N2-Sumikko/sekimen/doc/trackball_jp.md

こちらはトラックボールモジュール取付用の資料です。
# 同梱品の確認
以下の部品が揃っていることを確認します。

|名前|合計数|備考|
|:-|:-|:-|
|トラックボールモジュール用ボトムプレート|1枚|大きな丸い穴が開いたアクリル製の透明な板です。トラックボールモジュールの台座です。|
|トッププレート|1枚|大きな四角い穴が開いたアクリル製の透明な板です。ProMicroカバーも兼ねています。|
|M2x4mmスペーサー|2個|銀色の六角柱の形をした部品です。長さ4㎜です。|
|M2x6mmスペーサー|2個|銀色の六角柱の形をした部品です。長さ6㎜です。|
|細ピンヘッダ1x4|1個|ピンが細めの4ピンのピンヘッダです。|
|トッププレート用保護テープ|1枚|黒色の幅2mmのテープです。シートに貼り付けてあります。複数ある場合は予備です。|

# 別途必要な部品の用意
以下の部品を用意します。

|名前|合計数|備考|
|:-|:-|:-|
|7mmオプティカルトラックボールモジュール１uタイプ|1個|ビット・トレード・ワン様のトラックボールモジュール(型番：ADTB7M)です。以下、トラックボールモジュールと呼びます。|
|トラックボールモジュール用レベル変換基板|1個|のぎけす屋様のトラックボールモジュール用レベル変換基板です。以下、変換基板と呼びます。|

いずれも遊舎工房様の実店舗、[通販サイト](https://yushakobo.jp/shop/)等で購入可能です。

# 組立時の主な注意点
* 左キーボードの組立時にロープロファイルピンソケット1x4をはんだ付けしていない場合、トラックボールモジュールの取付は出来ません。ご注意ください。

　(組立後のロープロファイルピンソケット1x4の取付けは、邪魔になるキースイッチを取り外した後にトッププレートの一部を削れば可能かと思いますが、きっと大変です。今度一回試してみます。）

* トラックボールモジュールの配線を変換基板にはんだ付けする際は、変換基板の向きにご注意ください。

* トラックボールモジュール用レベル変換基板にピンヘッダ1x4をはんだ付けする際は、変換基板の向きと端子の位置にご注意ください。(変換基板のNC端子は使用しません。)

* アクリル製の部品にスペーサーの取付けやねじ止めをする際は、強い力をかけると破損の恐れがあるのでご注意ください。

# (左キーボードを組立済の場合)ProMicroカバー、OLED、M2x12mmスペーサー2つ、キースイッチの取外し

左キーボードの組立て中にこのページを見ている場合、この項目は無視して構いません。

組立とは逆の手順で、ProMicroカバー、OLED、M2x12mmスペーサー2つ、トラックボールモジュールを取付ける場所のキースイッチ（ProMicroの左のキースイッチ）の順に取外していきます。

ただしキースイッチの取外しには、はんだの吸取が必要です。はんだの吸取にははんだ吸い取り機等、専用の道具が必要となります。

道具を用意するか、遊舎工房様の工作室等を利用する等、環境を整えてから作業してください。

# M2x4mmスペーサーの取付け

画像の様に、M2x10mmのねじ2本にM2x4mmスペーサーをそれぞれ取付けます。取付時のトルクは、スペーサーを回転させたときにねじが回らない位の強さならOKです。

取付時にProMicroが邪魔な場合は取り外しておきます。(画像では取外しています。）

M2x4mmスペーサー取付後

上側のスペーサーは、ねじの頭を爪楊枝等の細い棒で抑えながら取付けると良いです。

下側のスペーサーは、一度ボトムプレートを取り外した後に、基板側から精密ドライバーでねじの頭を抑えながら取付ると良いです。

# 変換基板へのトラックボールモジュール配線のはんだ付け

画像のように、変換基板へトラックボールモジュールの配線をはんだ付けします。変換基板の向きに注意して下さい。

トラックボールモジュールはんだ付け後

# 変換基板へのピンヘッダ1x4のはんだ付け

画像のように、変換基板へピンヘッダ1x4を取付け、はんだ付けします。短い端子が変換基板側です。変換基板のNC端子にはピンヘッダは取付けないので注意して下さい。

トラックボールモジュールはんだ付け後

# トラックボールモジュール用ボトムプレートの穴へ変換基板を通す

トラックボールモジュール用ボトムプレートの保護シートをはがします。

その後、画像の様に、トラックボールモジュール用ボトムプレートの穴へ変換基板を通します。

ボトムプレートを通した後

# ピンヘッダ1x4のロープロファイルピンソケット1x4へ取付け

画像の様に、変換基板へはんだ付けしたピンヘッダ1x4を、左キーボード上のロープロファイルピンソケット1x4に、トッププレートを介して取付けます。

併せて、トラックボールモジュール用ボトムプレートの穴にM2x10mmねじを通します。

変換基板とボトムプレートの取付け

# M2x10mmねじへのM2x6㎜スペーサーの取付け

画像の様に、Mx10mmねじ2本へM2x6mmスペーサーをそれぞれ取付けます。

M2x6mmスペーサー取付後

# OLED(及びProMicro）の取付け

(取り外している場合は、ProMicroをメイン基板に取り付けた後に）OLEDをメイン基板へ取付けます。

# トラックボールモジュールの配線位置の調整

画像を参考に、トラックボールモジュールの配線を、左キーボードのトッププレートやトラックボールモジュール用ボトムプレートの穴へ通し、トラックボールモジュールをボトムプレートの上に置けるようにします。

配線格納後

# トッププレートへの保護テープ貼付け

トッププレートの保護シールをはがした後、画像の様にトッププレートの丸穴に2mm幅の保護テープを貼付けます。

保護テープ貼付後

保護テープを貼る目的は、丸穴のエッジを触らないようにするためと、トラックボールモジュールの固定のためです。

保護テープを貼りたくない場合は、丸穴のエッジをカッターナイフの背などで糸面取りしてもOKです。糸面取りについては、「アクリル　糸面取り」等で検索すると情報が得られると思います。

その場合トラックボールモジュールの角度がずれやすくなるので、気になるようでしたらトラックボールモジュールの裏側に両面テープ等を貼り、ボトムプレートに固定すると良いです。

# トッププレートをM2x6mmスペーサーへM2x4mmねじでねじ止め

画像の様に、トッププレートの丸穴にトラックボールモジュールを保護テープがずれないよう気を付けながら取付けた後に、トッププレートをM2x6mmスペーサー2つへM2x4mmねじ2本でねじ止めします。

トッププレート取付後

取付が完了したら、トラックボールモジュールの取付は完了です。

# ファームウェアの変更

この手順は、動作テストのためのファームウェアの書込みが完了していることを前提としています。
(つまり、qmk_firmwareのcloneを自分のPC上にダウンロード完了している状態）
拡張基板を使用していない場合はqmkのsekimenフォルダの5colsフォルダ内、
拡張基板を使用している場合は７colsフォルダ内のrules.mkの
POINTING_DEVICE_ENABLE = no
MOUSEKEY_ENABLE = no
のnoをyesに変更します。
その後、ProMicroへファームウェアの書込みを行います。

ファームウェアの内容に関しては、[こちら](https://github.com/sekigon-gonnoc/qmk_firmware/tree/dev/ble_micro_pro/keyboards/helix/rev2/keymaps/bto_tb)のせきごん様のリンクをご参考ください。
