N2-Sumikko/sekimen/data/plate/dxf/extension_bottomplate.dxf

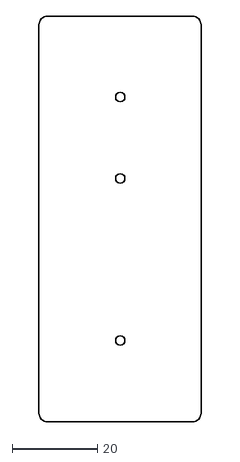
[picture p1: CAD file, 2020-11-23]
data/plate/dxf/extension_bottomplate.dxf
38.1 x 95.2
