N2-Sumikko/sekimen/data/plate/dxf/promicro_coverplate.dxf

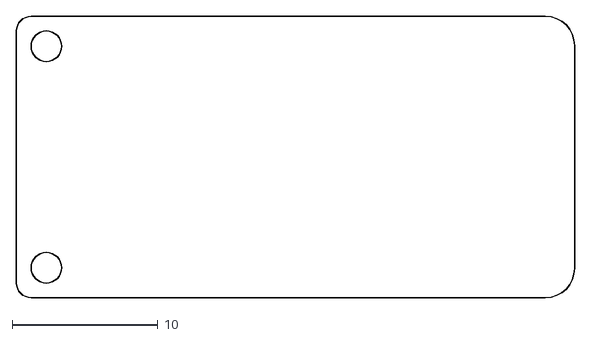
[picture p2: CAD file, 2020-11-23]
data/plate/dxf/promicro_coverplate.dxf
38.3 x 19.3
