N2-Sumikko/sekimen/data/plate/dxf/bottomplate.dxf

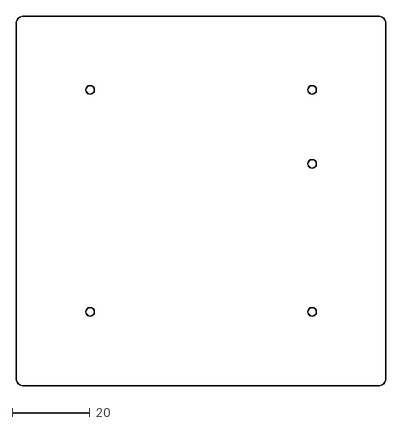
[picture p3: CAD file, 2020-11-23]
data/plate/dxf/bottomplate.dxf
95.2 x 95.2
