N2-Sumikko/sekimen/doc/Oparation_test_jp.md

# Operation test
こちらはsekimenの入力動作テスト用の資料です。

ファームウェア書込み環境を構築し、ProMicroへファームウェアを書き込み、キーボードの入力動作を確認するまでの手順を記載しています。(2020/07/30時点)

本手順はWindows(厳密にはWindows10)にてキャラクタユーザインターフェース用のソフトウェアであるMSYS2を使用する場合を基準にしています。

キーボード組立中や、キーボード組立後の入力動作テストにご活用ください。

# ファームウェア書込み環境の構築

ファームウェア書込み環境構築のため、QMK FirmwareのこちらのWeb ページ

https://docs.qmk.fm/#/ja/newbs_getting_started

を参考に、MSYS2及びgit、QMK CLIをインストールします。

また、こちらのWebページ等も非常に参考になるかと思います。(ページの作成者様にこの場を借りて感謝致します。)

https://qiita.com/mizuhof/items/0c34308c2d57c9345f3a

インストール後、PCのデスクトップ等に任意の名前のフォルダを1つ作成します。

(出来れば英語の、スペースを使用しないファイル名が良いです。github_workとか)

フォルダ

フォルダ作成後、フォルダの上にマウスカーソルを移動して右クリックします。その後「プロパティ」をクリックします。

クリック後、表示されたダイアログにて、画像の赤枠で囲んだ部分(フォルダのパス。フォルダの場所を示すもの）を控えておきます。

フォルダのパス

その後、MinGW 64-bit(mingw64.exe)を起動します。

mingw64起動後

起動後、次のコマンドを入力し、Enterキーを押します。

```
cd 控えておいたフォルダのパス(ただし、￥は/に置換えたもの)/作成したフォルダ
```

すると、先ほど作成したフォルダの中へ移動されます。画像の赤枠の部分が作成したフォルダのパスと一致していればOKです。

mingw64ファームウェア書込みフォルダ移動後

移動後、以下のコマンドを入力し、Enterキーを押します。(この部分はqmk_firmwareへのファームウェアのプルリクエストが完了するまでの仮の手順です。）

```
git clone --recurse-submodules https://github.com/N2-Sumikko/qmk_firmware.git -b add_sekimen
```

ファームウェア書込みに使用するフォルダが現在のフォルダにコピーされます。

その後、以下のコマンドを入力し、Enterキーを押します。

```
cd qmk_firmware
```

すると、ファームウェア書込みを行うフォルダの中へ移動されます。以上でファームウェア書込み環境の構築は完了です。

# ProMicroとPC間の接続

左右いずれかのProMicroの取付けまで完了したキーボードのProMicroとPC間をUSBケーブルで接続します。

sekimenは左キーボードのProMicroへUSBケーブルを接続して使用しますが、ファームウェアは左右両方のProMicroへ書き込む必要がありますので注意してください。

USBケーブルには充電のみ可能なものと、通信可能なものがありますので、通信可能なものを使用してください。

# ProMicroへのファームウェア書込み

接続後、ファームウェア書込み用のコマンドを入力し、Enterキーを押します。

通常時(5列)と拡張基板使用時(7列)でコマンドが違うので注意してください。

(defaultの部分は必要に応じてlike_jisやviaに変更してください。）

通常時
```
make sekimen/5cols:default:avrdude
```

拡張基板使用時
```
make sekimen/7cols:default:avrdude
```

すると、ファームウェアの書込みが開始されます。(書込み開始まで少し時間がかかる場合があるので、しばらく待ちます。)

しばらくすると画像のように「.」が 1つずつ増えていく状態になります。

mingw64リセット待機中

その状態で、画像のようにピンセット等でリセットスイッチを押します。(画像は説明のため、USBケーブルを取外しています。)

リセットスイッチ押下

リセットスイッチを押すと画面の状態が変わり、処理が先に進みます。画像のように「Thank you.」が表示されたら、ファームウェアの書込みは完了です。

ファームウェア書込み完了後

もう片方のキーボードに対しても同様の手順でファームウェアを書き込みます。

# 左右のキーボードのTRRSケーブルでの接続

左右のキーボードのTRRSジャック間をTRRSケーブルで接続します。TRRSケーブルは画像のように奥まで差し込んでください。

TRRSケーブル接続後

# **左キーボード**のProMicroとPC間をUSBケーブルで接続

**左キーボード**のProMicroとPC間をUSBケーブルで接続します。**左キーボード**ですので注意して下さい。

sekimenは左キーボードのProMicroにUSBケーブルを接続しないと正しく動作しません。

# 入力動作テスト

左右のキーボード間をTRRSケーブル、左キーボードとPC間をUSBケーブルで接続した状態で以下のURLをクリックし、キーボードテスター様のサイトを表示します。

https://www.keyboardtester.com/tester.html

その後、画像のようにピンセット等で、基板のキースイッチ用のランド(キースイッチの端子をはんだ付けする場所)間をショートさせます。

(ピンセットではなく、押した状態のキースイッチを使用して動作確認を兼ねるのも良いかと思います。スイッチがはんだ付け済みの場合はスイッチを押します。)

入力動作確認用

組立が正しく行われていれば、ショートさせた箇所に対応するキーが入力されます。

どのランドがどのキーに対応するかは、keymap.cの中身を確認すると良いです。（ここちょっとわかりにくいので追記予定）

これを左右基板の各端子、もしくはキースイッチに対して行います。

(レイヤキーの動作テストに関しては、例えばsekimenのデフォルトのキーマップでは、RAISEのレイヤキーを入力しながらqキーを押すと1が入力されるので、それらを利用して確認すると良いです。)

キーマップ通りにキーが入力されることを確認したら、入力動作テストは完了です。

問題がある場合は、

*   はんだ付けが行われていない場所が無いか

*   はんだが不十分な場所は無いか

*   本来繋がらない筈の箇所がはんだで繋がっていないか

*   使用している部品に問題は無いか

*   ダイオード等の部品の向きは正しいか

等を確認します。異常がある場所を見つけたら1つずつ修正していき、改めて動作を確認します。
